eosti/lamp-sao/hpl_lamp_v1/OUTPUTS/DOCS/hpl_lamp_v1-0.png

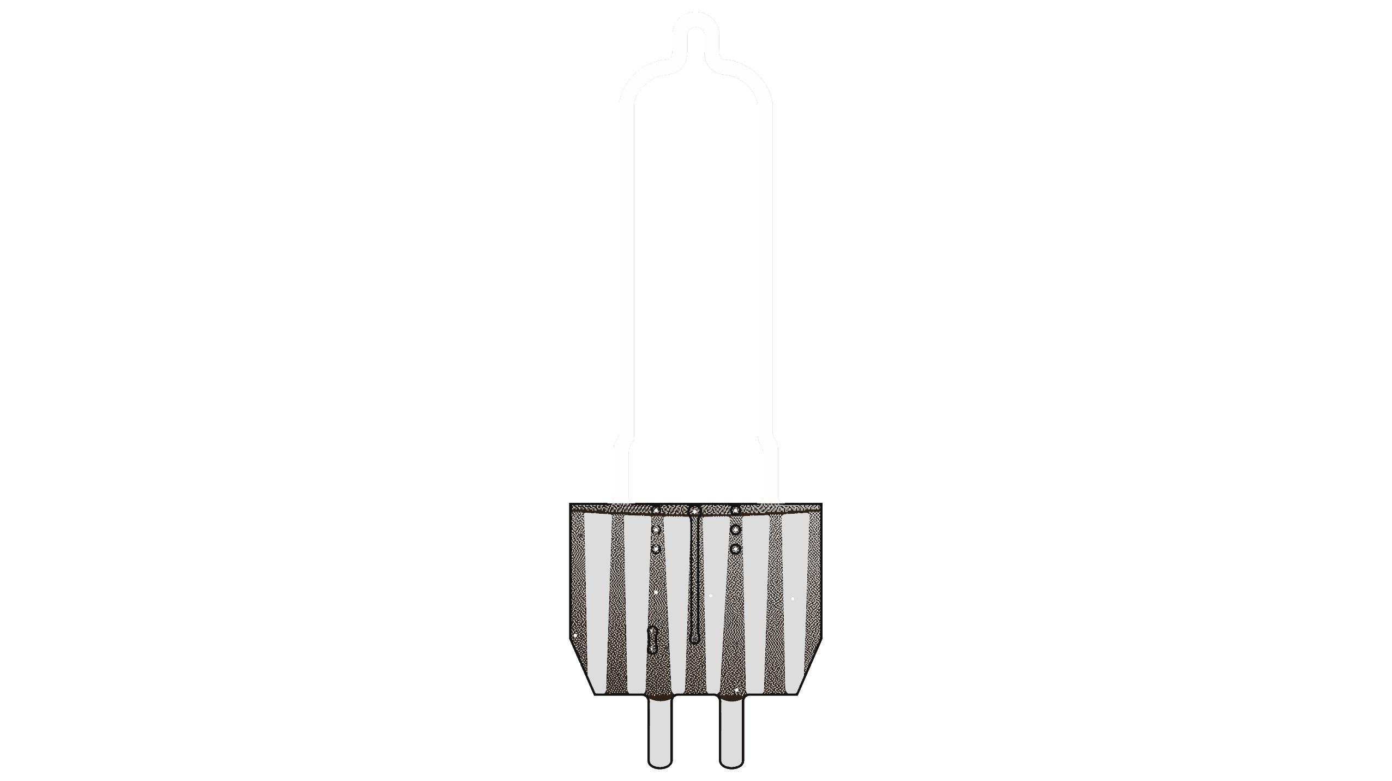
hpl_lamp_v1/OUTPUTS/DOCS/hpl_lamp_v1-0.png
