eosti/lamp-sao/assembly_jigs/C9 Holder - Part 1.stl

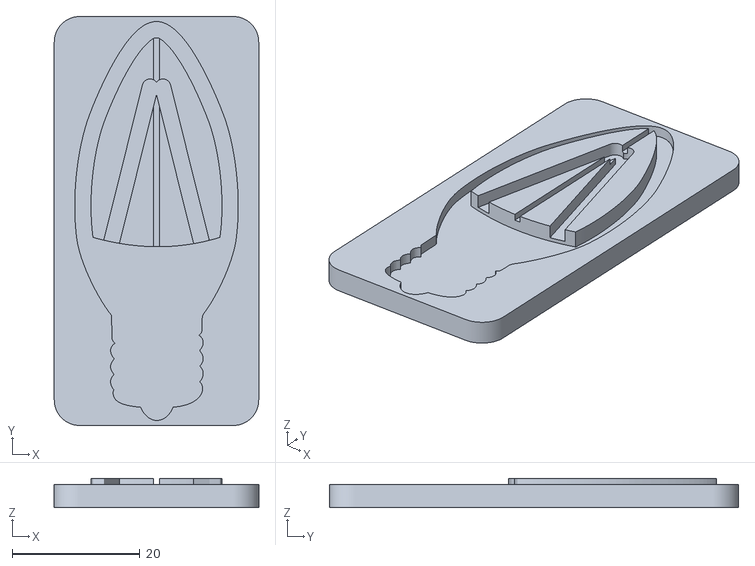
[picture p2: CAD file, 2026-11-06]
assembly_jigs/C9 Holder - Part 1.stl
32.0 x 64.0 x 4.60
