eosti/lamp-sao/hpl_lamp_v1/OUTPUTS/DOCS/.step

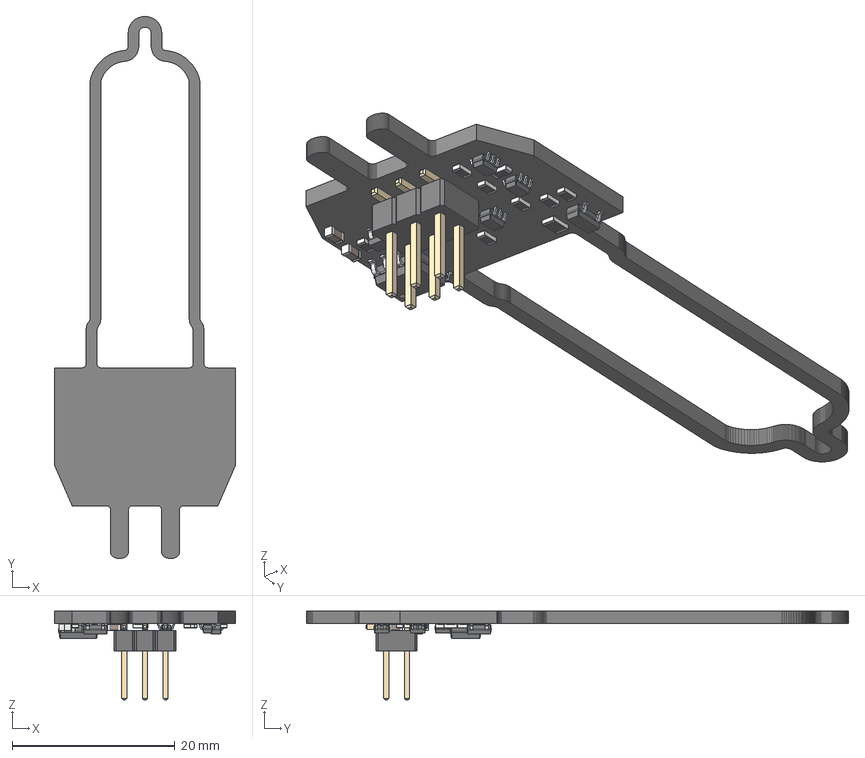
[picture p3: CAD file, 2026-11-06]
hpl_lamp_v1/OUTPUTS/DOCS/.step
22.3 x 66.6 x 10.9 mm
C_0603_1608Metric x 3
SOT-363_SC-70-6 x 3
SOIC-8_3.9x4.9mm_P1.27mm
SOT-23 x 2
R_0603_1608Metric x 9
R_0805_2012Metric
PinHeader_2x03_P254mm_Vertical_SMD
hpl_lamp_v1_PCB
