eosti/lamp-sao/assembly_jigs/HPL Holder Pt1 - Part 1.stl

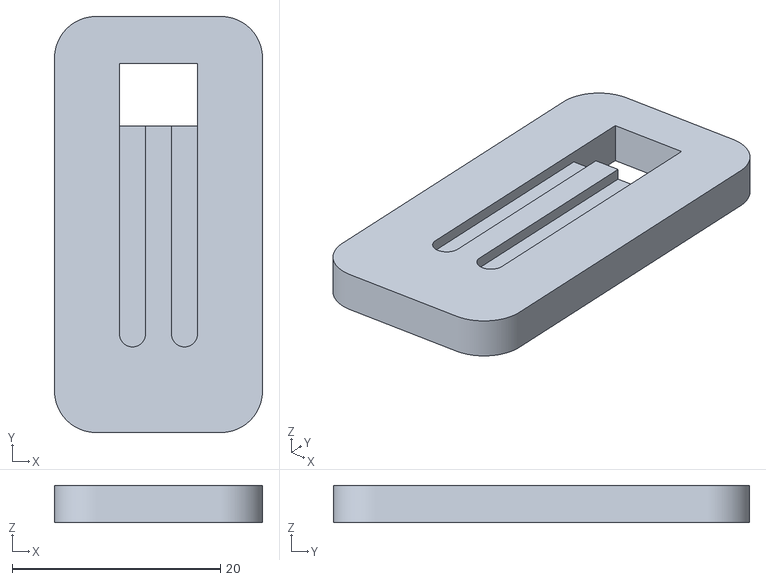
[picture p4: CAD file, 2026-11-06]
assembly_jigs/HPL Holder Pt1 - Part 1.stl
20.0 x 40.0 x 3.60
