eosti/lamp-sao/assembly_jigs/HPL Holder Pt2 - Part 1.stl

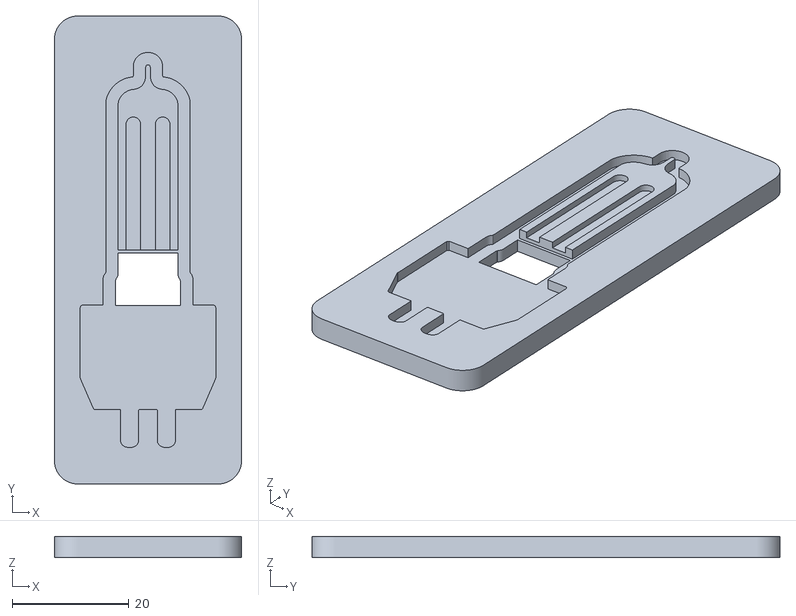
[picture p5: CAD file, 2026-11-06]
assembly_jigs/HPL Holder Pt2 - Part 1.stl
32.0 x 80.0 x 3.60
