eosti/lamp-sao/hpl_lamp_v0/OUTPUTS/DOCS/.step

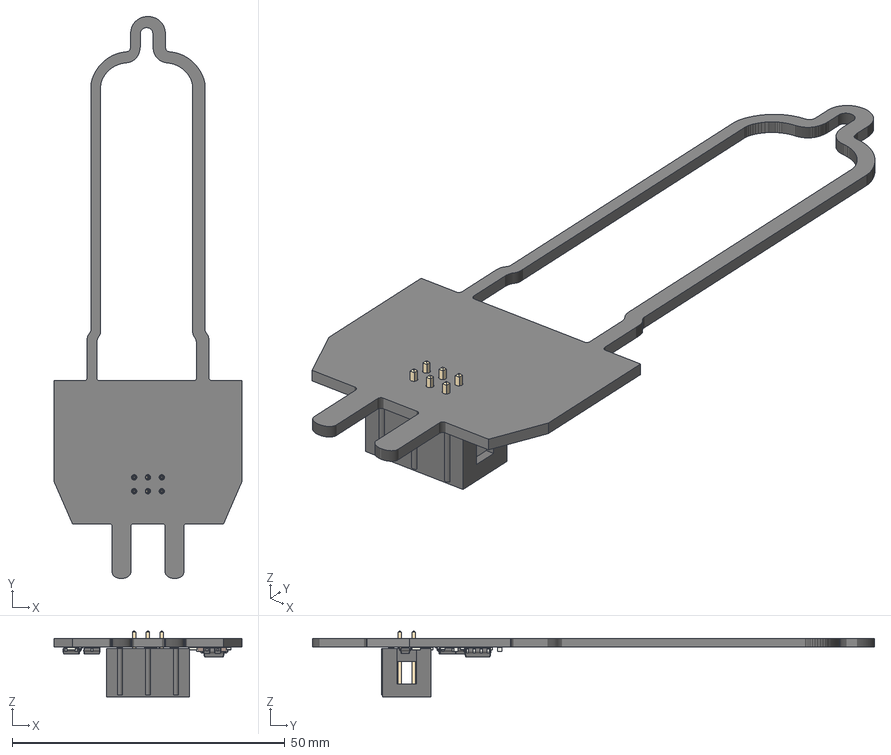
[picture p6: CAD file, 2026-11-06, an earlier design]
hpl_lamp_v0/OUTPUTS/DOCS/.step
34.5 x 103.1 x 12.1 mm
C_0603_1608Metric x 3
D_SOD-323 x 2
SOIC-8_3.9x4.9mm_P1.27mm
R_0603_1608Metric x 10
SOT-23 x 5
R_0805_2012Metric
IDC_Header_2x03_P254mm_Vertical
hpl_lamp_v0_PCB
