eosti/lamp-sao/hpl_lamp_v0/OUTPUTS/DOCS/hpl_lamp_v0.pdf

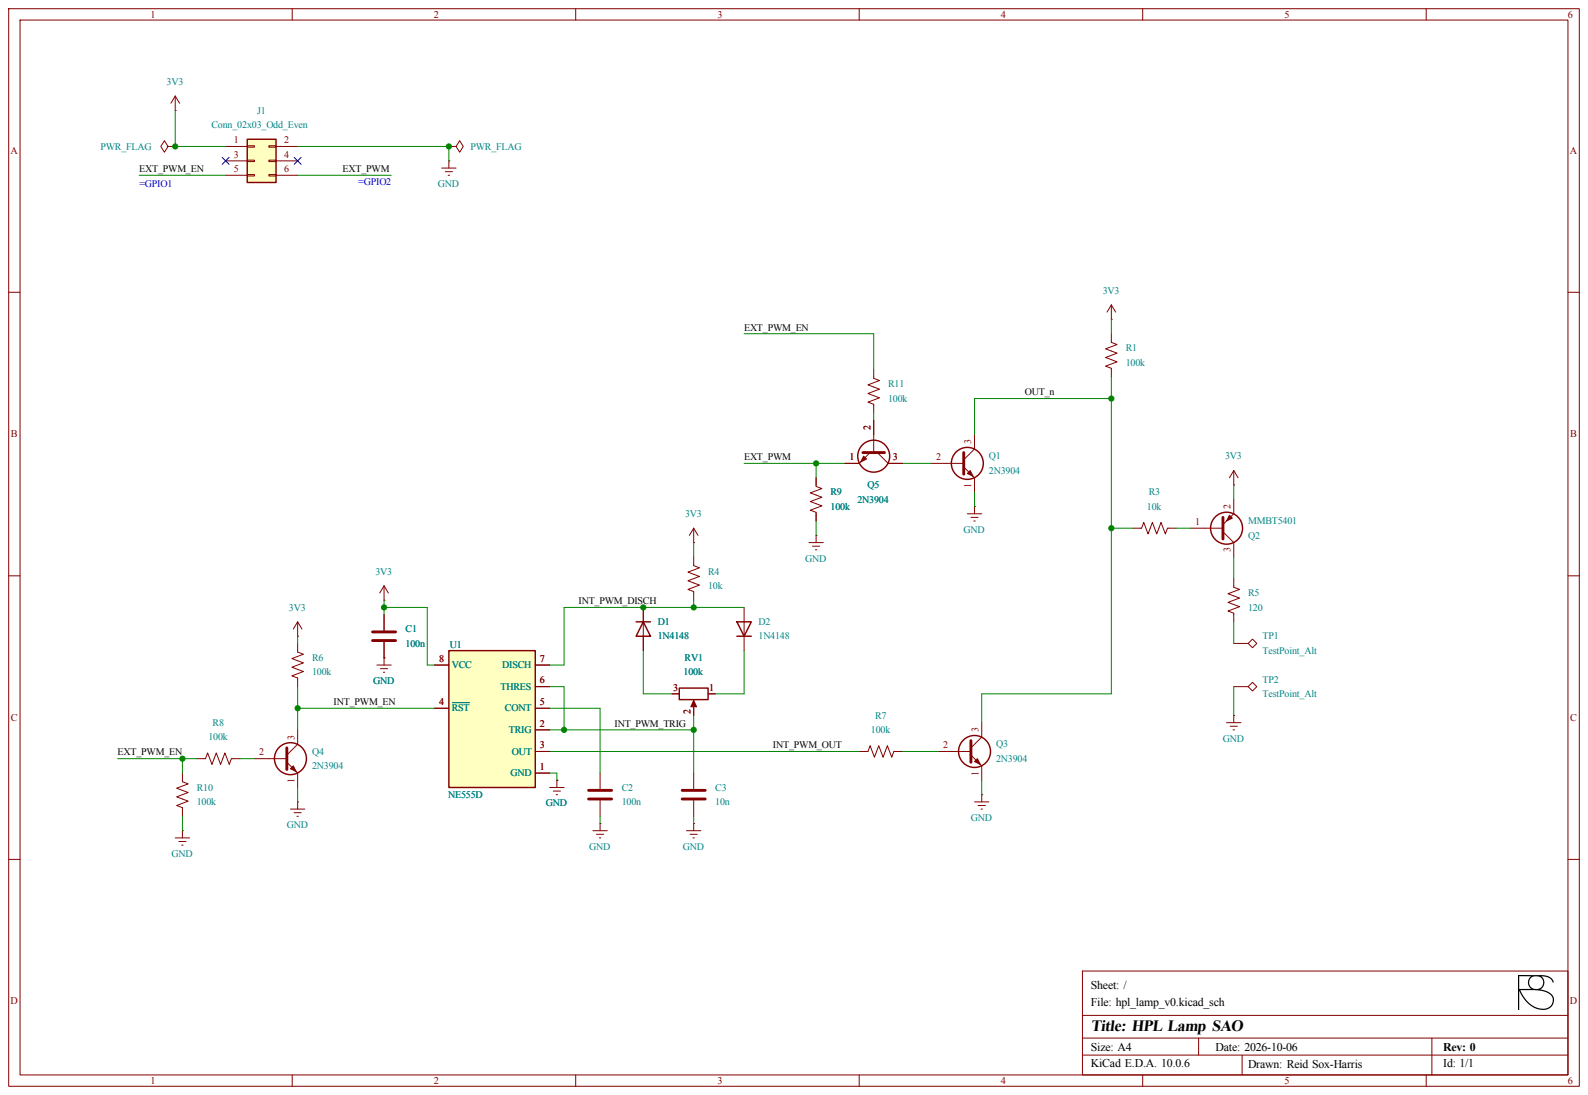
[picture p8: page 1]

Id: 1/1 Title: HPL Lamp SAO
