eosti/lamp-sao/sims/muxed-pwm.asc

C1: cap; 100n
C2: cap; .01µ
D3: LED; LXZ1-PB01
Q1: npn; 2N3904
Q2: npn; 2N3904
Q3: pnp; 2N5401
Q4: npn; 2N3904
Q5: npn; 2N3904
Q6: npn; 2N3904
R1: res; 10k
R2: res; {100k - Rvar}
R3: res; {Rvar}
R4: res; 120
R5: res; 100k
R6: res; 100k
R7: res; 100k
R9: res; 10k
R10: res; 100k
R11: res; 100k
R12: res; 100k
R13: res; 100k
U1: NE555
U2: BAV99
U3: BAV99
V1: voltage; 3.3
V2: voltage; PULSE(0 3.3 0 .01 .01 .25 .5)
V3: voltage; PULSE(0 3.3 0 1e-6 1e-6 5e-4 1e-3)
Named nets: 0, vcc, p26, ext_pwm_en, 555_pwm, ext_pwm
.param Rvar=50k
.tran 0 1 0
