eosti/lamp-sao/hpl_lamp_v0/hpl_lamp_v0.kicad_pcb

## KiCad design hpl_lamp_v0/hpl_lamp_v0.kicad_pcb (2026-11-06, an earlier design)

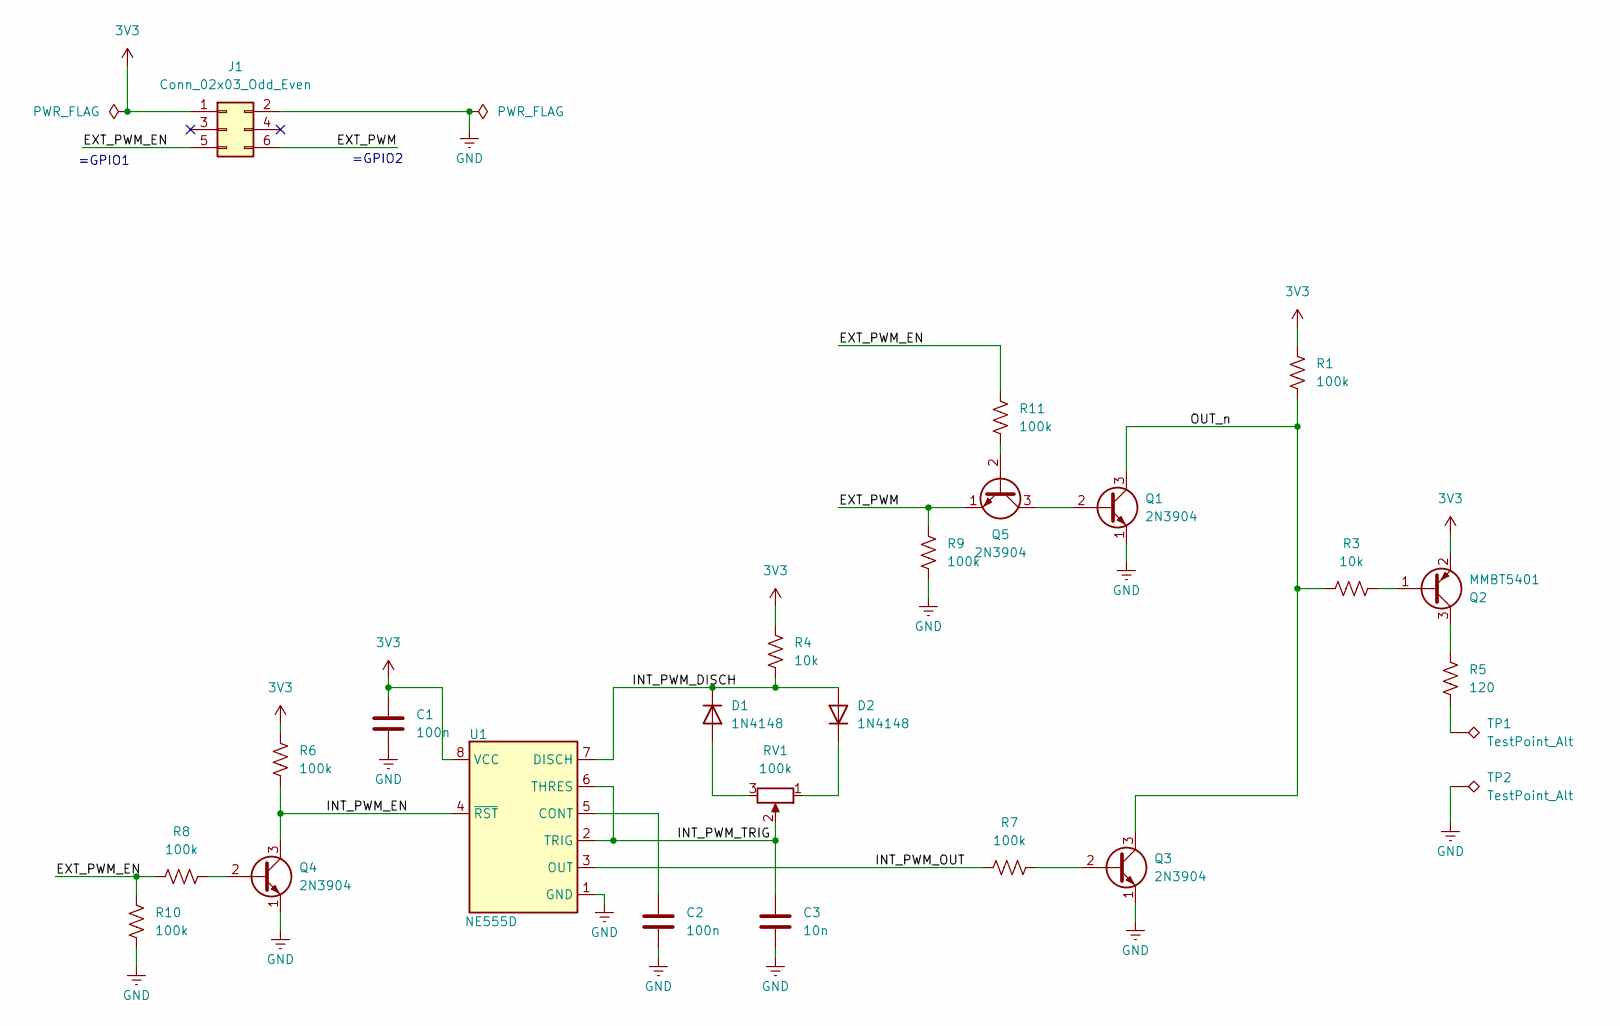
[picture p9: schematic hpl_lamp_v0.kicad_sch, HPL Lamp SAO]

Parts:
C1, C2: 100n; C_0603_1608Metric; LCSC C14663
C3: 10n; C_0603_1608Metric; LCSC C57112
D1, D2: 1N4148; D_SOD-323; LCSC C2128
J1: Conn_02x03_Odd_Even; IDC-Header_2x03_P2.54mm_Vertical
Q1, Q3, Q4, Q5: 2N3904; SOT-23; LCSC C20526
Q2: MMBT5401; SOT-23; LCSC C8326
R1, R6, R7, R8, R9, R10, R11: 100k; R_0603_1608Metric; LCSC C25803
R3, R4: 10k; R_0603_1608Metric; LCSC C25804
R5: 120; R_0805_2012Metric; LCSC C17437
RV1: 100k; Potentiometer_Bourns_TC33X_Vertical; LCSC C48997895
TP1, TP2: TestPoint_Alt; filament_connection
U1: NE555D; SOIC-8_3.9x4.9mm_P1.27mm; LCSC C7593

Connections:
3V3: C1.1, J1.1, Q2.2 (E), R1.1, R4.1, R6.1, U1.8 (VCC)
/EXT_PWM: J1.6, Q5.1 (E), R9.1; also elsewhere on the board
/EXT_PWM_EN: J1.5, R8.2, R10.1, R11.1
/INT_PWM_DISCH: D1.1 (K), D2.2 (A), R4.2, U1.7 (DISCH)
/INT_PWM_EN: Q4.3 (C), R6.2, U1.4 (~RST)
/INT_PWM_OUT: R7.2, U1.3 (OUT)
/INT_PWM_TRIG: C3.1, RV1.2, U1.2 (TRIG), U1.6 (THRES)
/OUT_n: Q1.3 (C), Q3.3 (C), R1.2, R3.2
GND: C1.2, C2.2, C3.2, J1.2, Q1.1 (E), Q3.1 (E), Q4.1 (E), R9.2, R10.2, TP2.1 (1_1), U1.1 (GND)
unnamed: D1.2 (A), RV1.3
unnamed: D2.1 (K), RV1.1
unnamed 11: Q1.2 (B), Q5.3 (C); also elsewhere on the board
unnamed: Q2.1 (B), R3.1
unnamed: Q2.3 (C), R5.1
unnamed: Q3.2 (B), R7.1
unnamed: Q4.2 (B), R8.1
unnamed: Q5.2 (B), R11.2
unnamed: R5.2, TP1.1 (1_1)
unnamed: C2.1, U1.5 (CONT)

Notes on the sheet:
=GPIO2
=GPIO1

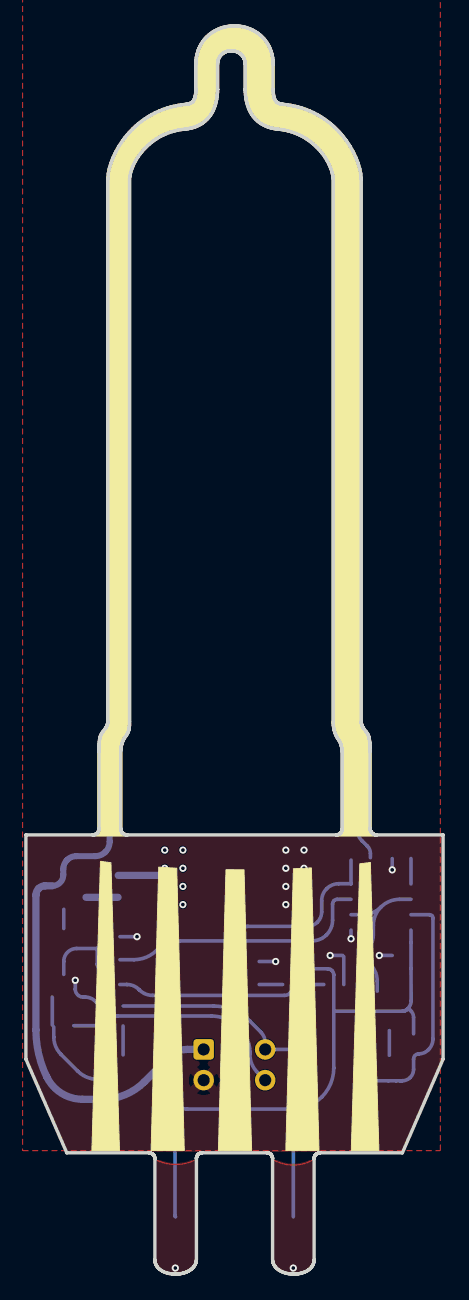
[picture p10: board hpl_lamp_v0.kicad_pcb from above]

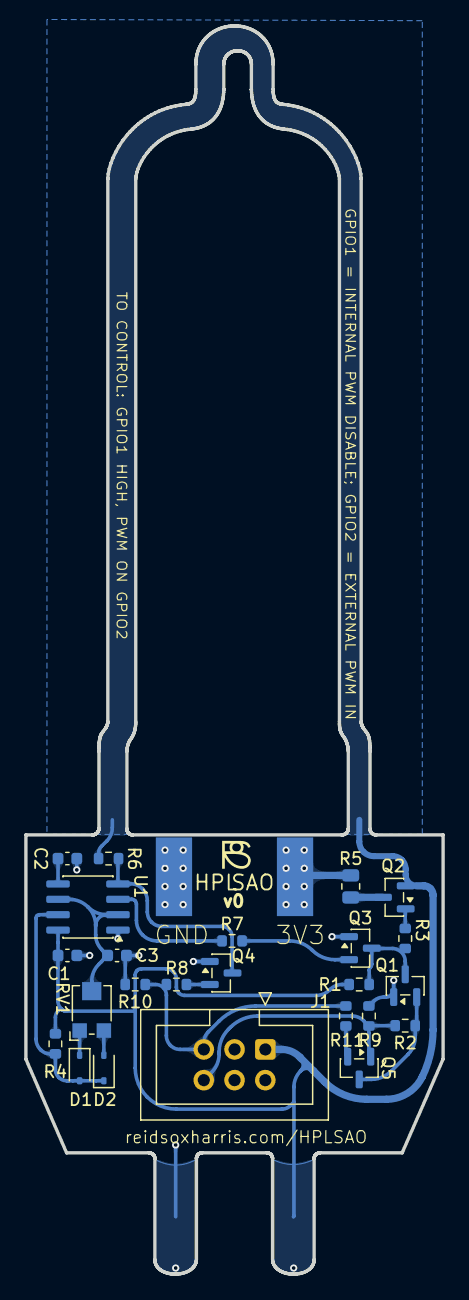
[picture p11: board hpl_lamp_v0.kicad_pcb from below]

Board: 2 copper layers, 34.5 x 103.1 mm, 26 parts (26 on the bottom side), 19 nets.

Other parts of the board:
R2: 10k; R_0603_1608Metric

Their connections:
/EXT_PWM: R2.2; also elsewhere on the board
unnamed 11: R2.1; also elsewhere on the board
