eosti/lamp-sao/hpl_lamp_v1/hpl_lamp_v1.kicad_pcb

## KiCad design hpl_lamp_v1/hpl_lamp_v1.kicad_pcb (2026-11-06)

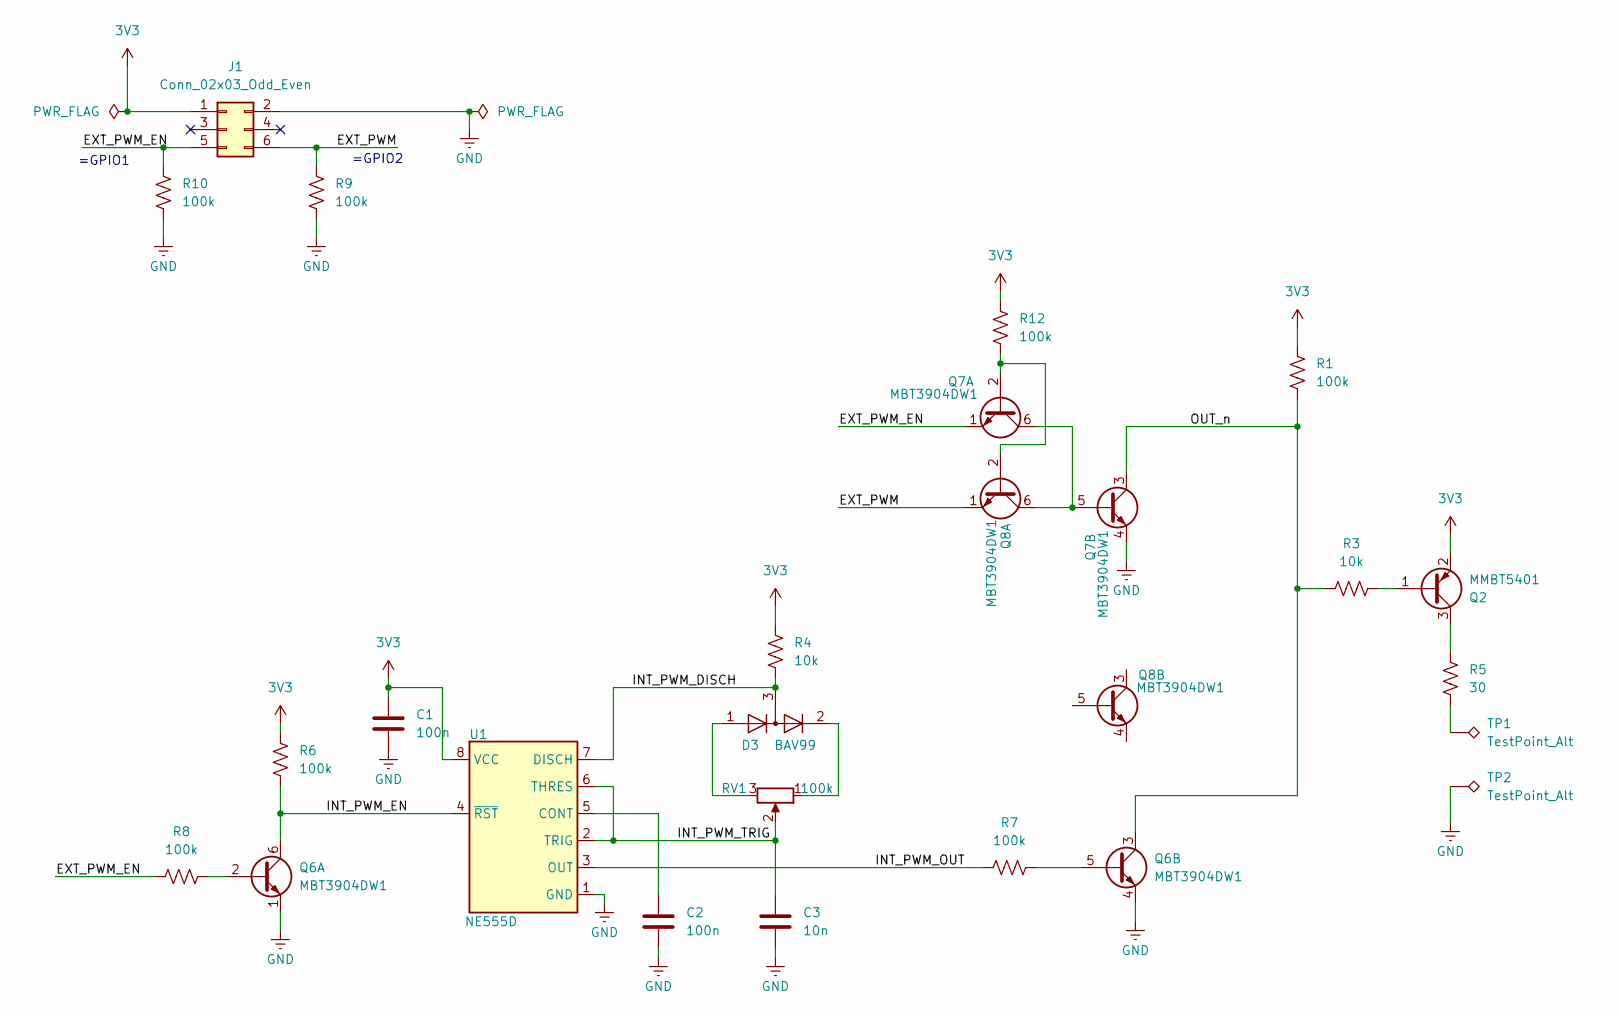
[picture p12: schematic hpl_lamp_v1.kicad_sch, HPL Lamp SAO]

Parts:
C1, C2: 100n; C_0603_1608Metric; LCSC C14663
C3: 10n; C_0603_1608Metric; LCSC C57112
D3: BAV99; SOT-23
J1: Conn_02x03_Odd_Even; PinHeader_2x03_P2.54mm_Vertical_SMD
Q2: MMBT5401; SOT-23; LCSC C8326
Q6, Q7, Q8: MBT3904DW1; SOT-363_SC-70-6
R1, R6, R7, R8, R9, R10, R12: 100k; R_0603_1608Metric; LCSC C25803
R3, R4: 10k; R_0603_1608Metric; LCSC C25804
R5: 30; R_0805_2012Metric; LCSC C17437
RV1: 100k; Potentiometer_Bourns_TC33X_Vertical; LCSC C48997895
TP1, TP2: TestPoint_Alt; filament_connection
U1: NE555D; SOIC-8_3.9x4.9mm_P1.27mm; LCSC C7593

Connections:
3V3: C1.1, J1.1, Q2.2 (E), R1.1, R4.1, R6.1, R12.1, U1.8 (VCC)
/EXT_PWM: J1.6, Q8.1 (E1), R9.1
/EXT_PWM_EN: J1.5, Q7.1 (E1), R8.2, R10.1
/INT_PWM_DISCH: D3.3 (K), R4.2, U1.7 (DISCH)
/INT_PWM_EN: Q6.6 (C1), R6.2, U1.4 (~RST)
/INT_PWM_OUT: R7.2, U1.3 (OUT)
/INT_PWM_TRIG: C3.1, RV1.2, U1.2 (TRIG), U1.6 (THRES)
/OUT_n: Q6.3 (C2), Q7.3 (C2), R1.2, R3.2
GND: C1.2, C2.2, C3.2, J1.2, Q6.1 (E1), Q6.4 (E2), Q7.4 (E2), R9.2, R10.2, TP2.1 (1_1), U1.1 (GND)
unnamed: D3.2 (A), RV1.1
unnamed: D3.1 (K), RV1.3
unnamed: Q2.1 (B), R3.1
unnamed: Q2.3 (C), R5.1
unnamed: Q6.2 (B1), R8.1
unnamed: Q6.5 (B2), R7.1
unnamed: Q7.2 (B1), Q8.2 (B1), R12.2
unnamed: Q7.5 (B2), Q7.6 (C1), Q8.6 (C1)
unnamed: R5.2, TP1.1 (1_1)
unnamed: C2.1, U1.5 (CONT)

Notes on the sheet:
=GPIO2
=GPIO1

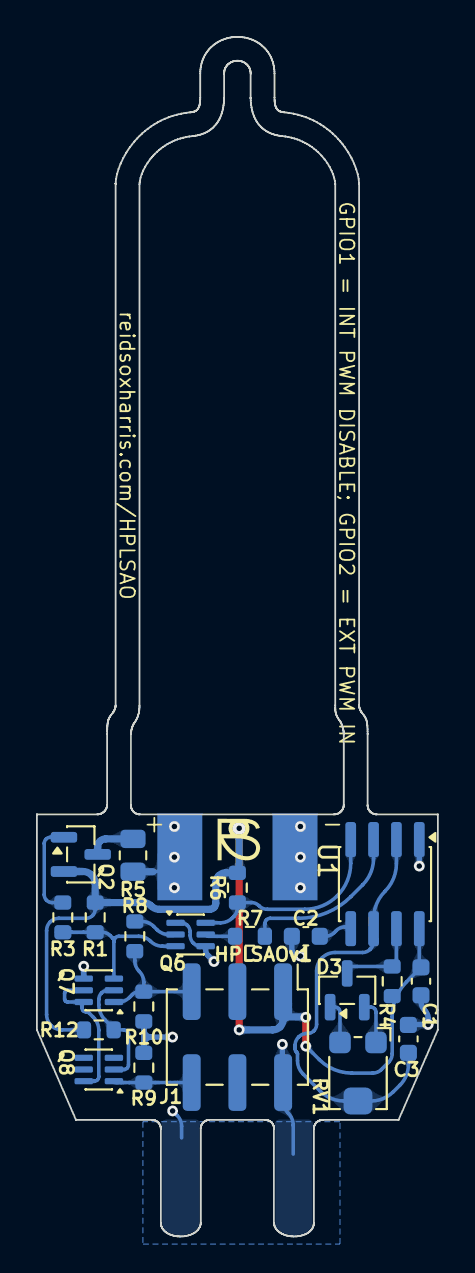
[picture p13: board hpl_lamp_v1.kicad_pcb from below]

Board: 2 copper layers, 22.3 x 66.6 mm, 23 parts (23 on the bottom side), 19 nets.
