eosti/lamp-sao/(commit log)

2026-11-06 intial commit
    [.step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]
2026-11-06 add 3dp jigs
    [C9 Holder - Part 1.stl, HPL Holder Pt1 - Part 1.stl, HPL Holder Pt2 - Part 1.stl]
